David-Mengel/ECE-445-notebook---Tesla-Coil-Guitar-Amp-Group-13-2023/IMG_20231201_160136043_HDR.jpg

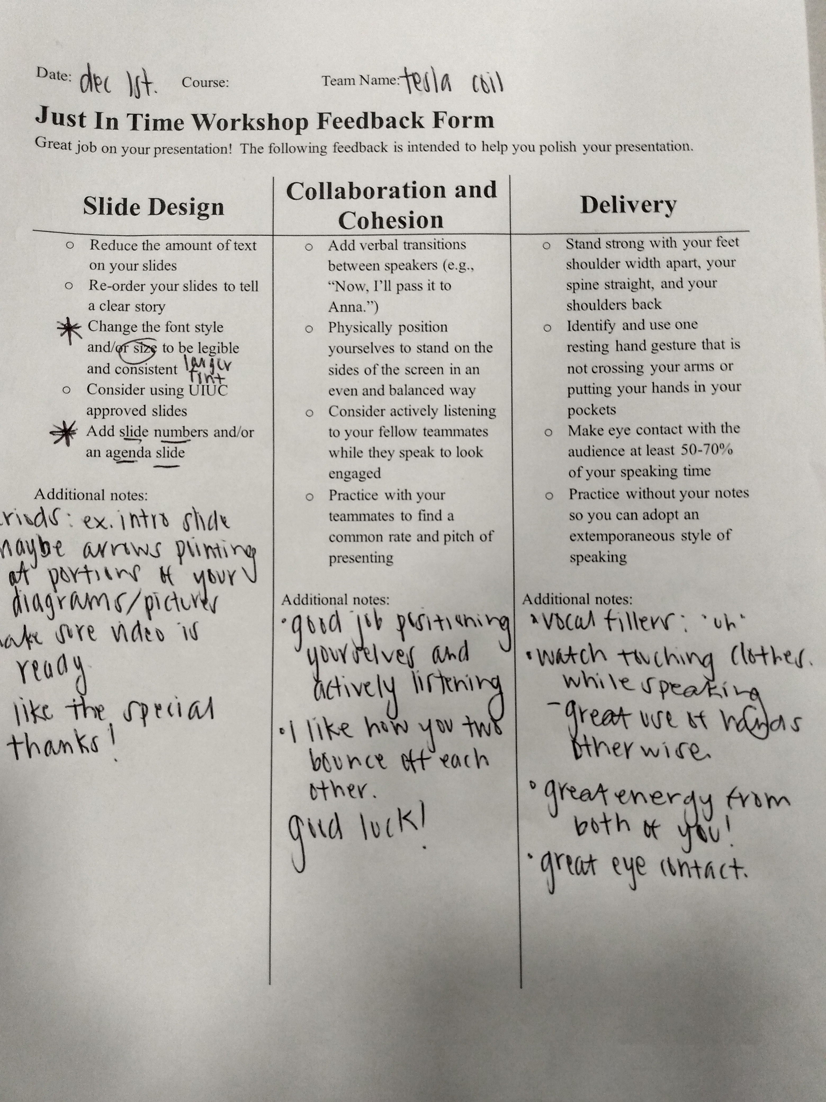
IMG_20231201_160136043_HDR.jpg
