David-Mengel/ECE-445-notebook---Tesla-Coil-Guitar-Amp-Group-13-2023/README

This repo contains the notes created by Griffin Rzonca and David Mengel for their ECE 445 project, the Tesla Coil Guitar Amp. 
For Final Report and other writeups, see Deliverables Folder
For information on when each file was written, see Version Information Document
Special thanks to Arne Fliflet, Jason Paximadas, and Arijit Banerjee for Guidance
