David-Mengel/ECE-445-notebook---Tesla-Coil-Guitar-Amp-Group-13-2023/MeetingNotes/10_2_23 Group Meeting.docx

Griffin Rzonca, David Mengel, Aditya Anand

ECE 445

10/2/23

Team 13 10/2 Meeting

Goals:

- Discuss gate drivers
- Discuss Audio processing goals
- Prepare for design review - 10/4 Wednesday, 12pm

Gate Drivers:

Do we need de-glitching?

Ask about gate driver circuit
