David-Mengel/ECE-445-notebook---Tesla-Coil-Guitar-Amp-Group-13-2023/MeetingNotes/11_7_23 TA Meeting.docx

11/7/23

Griffin Rzonca

ECE 445

11/7/23 Meeting with Jason

- Mock Demos next week
- Power board nearly soldered
- Audio Board arrived yet?
  - No
- 100k pot, actual ESP32 Wroom chip, USB/UART - need
- Still waiting on lab access to be approved
  - I’ll email them again
