David-Mengel/ECE-445-notebook---Tesla-Coil-Guitar-Amp-Group-13-2023/Audio Board/Coding the ESP32.docx

11/13/23

Griffin Rzonca

Coding the ESP32 Notes

- Testing with Devkit first
- Plug USB to microUSB connector into UART port
- Test with AD9850 board to ensure proper control
- AD9850 Arduino Library that may work with ESP32: AD985X/examples/AD9850_ESP32_HWSPI/AD9850_ESP32_HWSPI.ino at master · RobTillaart/AD985X · GitHub (https://github.com/RobTillaart/AD985X/blob/master/examples/AD9850_ESP32_HWSPI/AD9850_ESP32_HWSPI.ino)
