David-Mengel/ECE-445-notebook---Tesla-Coil-Guitar-Amp-Group-13-2023/Version Information.pdf

12/7/23

Griffin Rzonca and David Mengel

ECE 445, Team 13

Photo Screenshots of file dates

This file contains screenshots of the modification dates of each document in the lab notebook.

Dates are also included at the top of each file, but this document is intended to provide additional

context in a centralized location.

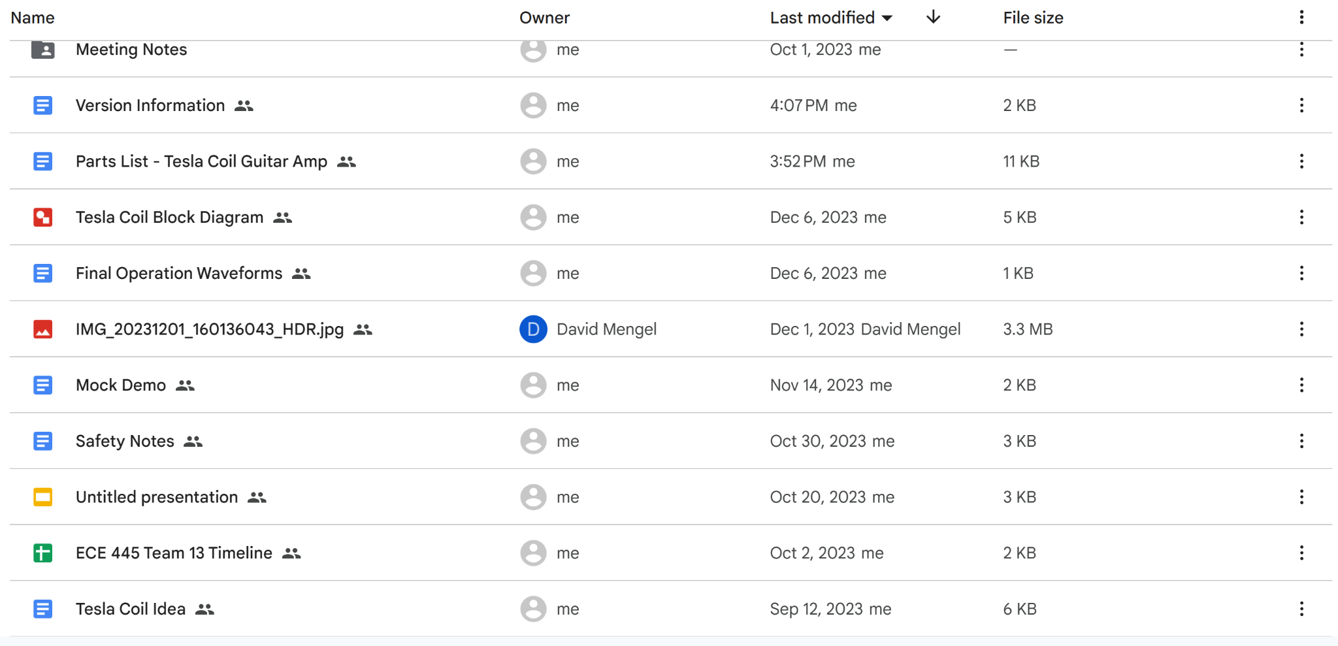
[picture p19: figure]

Above: Main folder version information

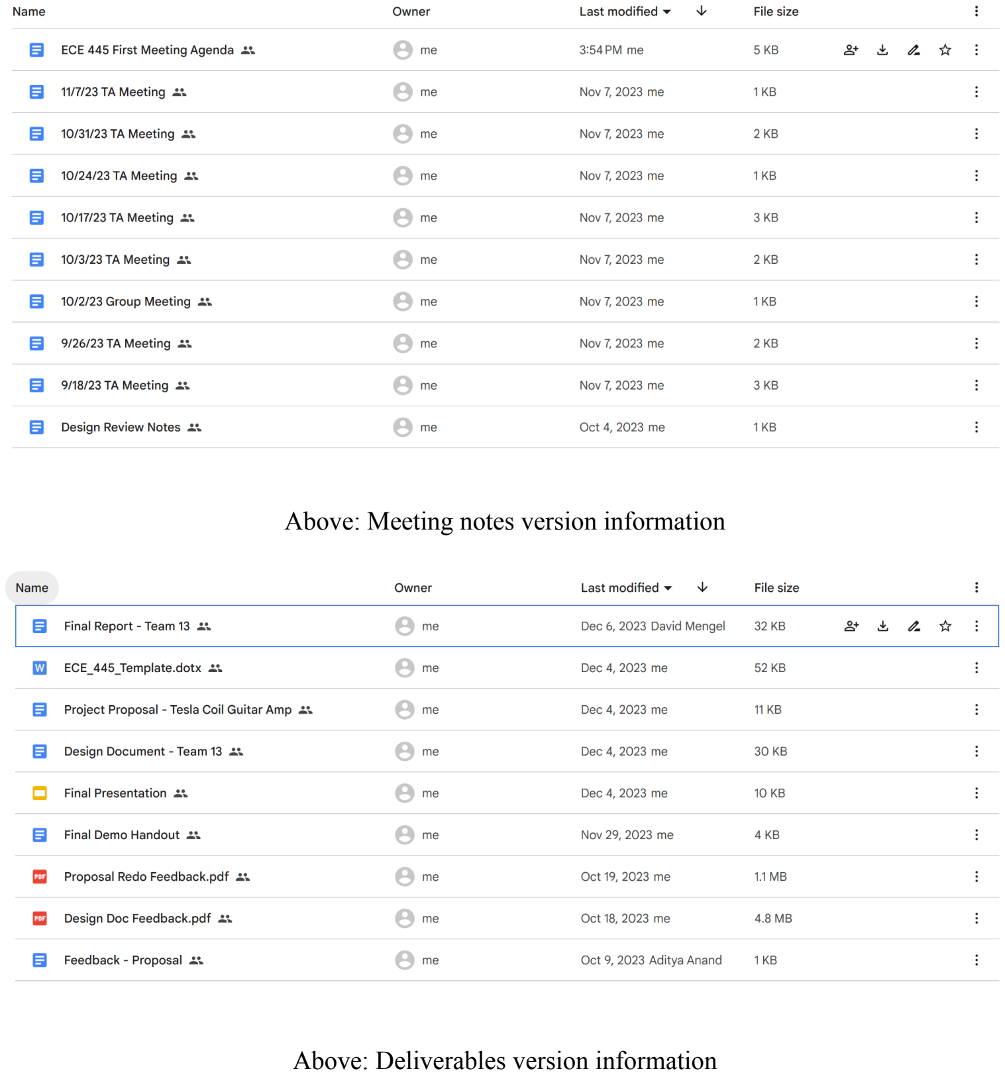
[picture p20: page 2]

Above: Meeting notes version information

Above: Deliverables version information

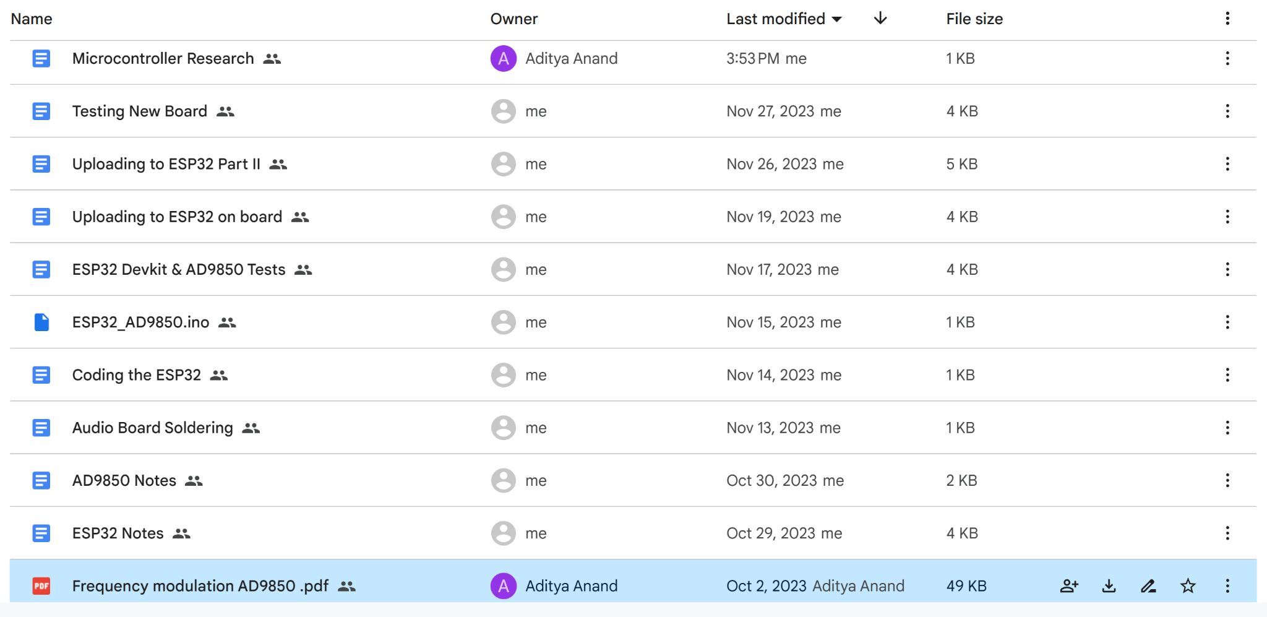
[picture p21: figure]

Above: Audio Board version information

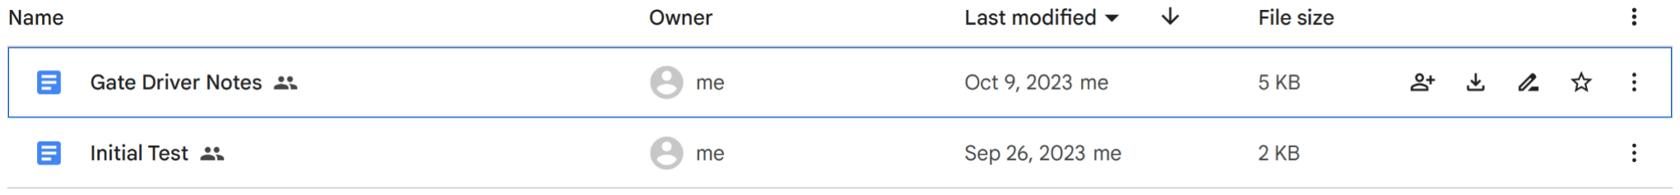
[picture p22: figure]

Above: Power Board version information
