David-Mengel/ECE-445-notebook---Tesla-Coil-Guitar-Amp-Group-13-2023/Tesla Coil Block Diagram.jpg

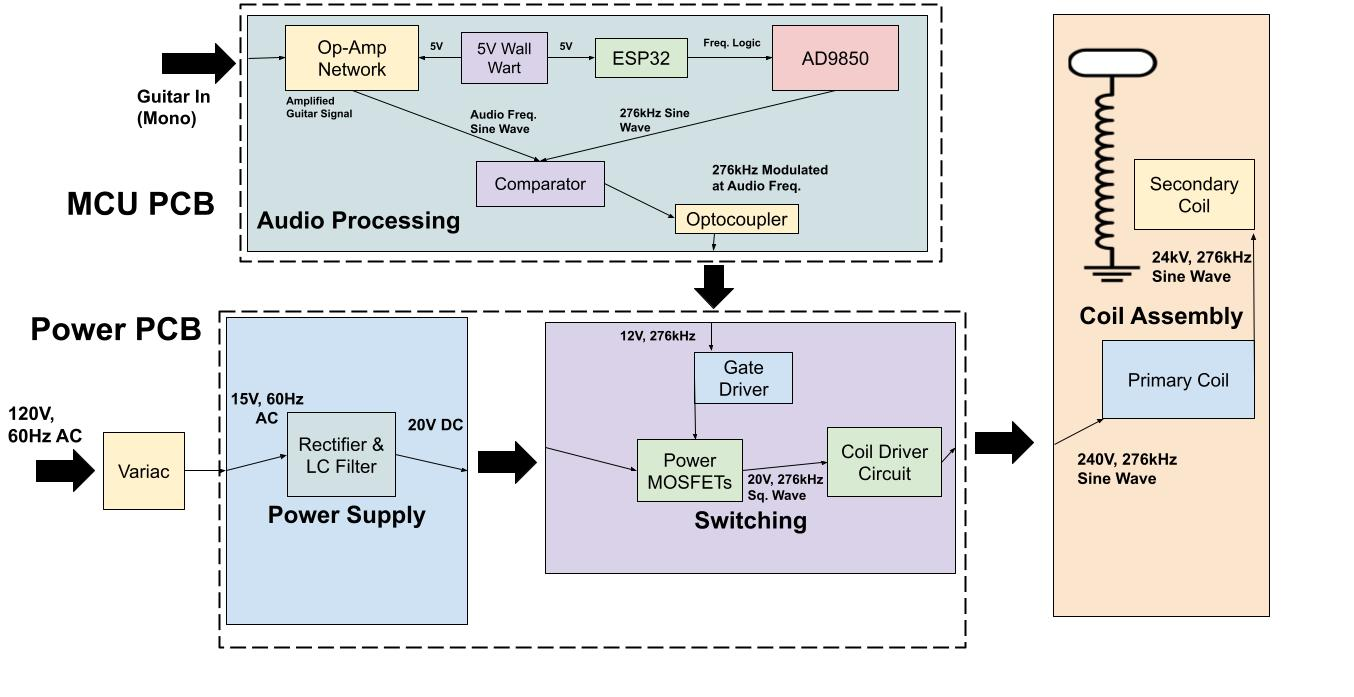
Tesla Coil Block Diagram.jpg
