David-Mengel/ECE-445-notebook---Tesla-Coil-Guitar-Amp-Group-13-2023/Parts List - Tesla Coil Guitar Amp.docx

Team 13 - Griffin Rzonca & David Mengel

ECE 445

Unsure about: Capacitors, AD9850, Wall Warts, and power strips, power/extension cord

Final list:

Gate driver:

2-mouser.com/ProductDetail/Skyworks-Solutions-Inc/SI82394CD4-IS?qs=7DnIVh14JBvCzUtYbocglg%3D%3D

Power Board:
Rectifier

2-https://www.mouser.com/ProductDetail/Diotec-Semiconductor/DB35-10?qs=OlC7AqGiEDlsV5lyy2qneA%3D%3D

Large Electrolytic capacitor:

In closet of 469 lab, or use https://www.mouser.com/ProductDetail/KEMET/ALC70A102EL500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

Smaller thin film capacitors: (10 Needed)
https://www.mouser.com/ProductDetail/Cornell-Dubilier-CDE/106MMR250K?qs=3tP%252BN51vMXeUCf%2FkKoeJiw%3D%3D

.05 uF capacitor

1-https://www.ebay.com/itm/171746725055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

Fuses:

10-https://www.mouser.com/ProductDetail/Bel-Fuse/5SF-10-R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 (could go different amperage)

Fuse Clips

10-https://www.mouser.com/ProductDetail/Littelfuse/52000001009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

Transistors

4-https://www.digikey.com/en/products/detail/stmicro/STW65N65DM2AG/5724364?

Circuit Breaker

2-https://www.mouser.com/ProductDetail/Qualtek/QLB-103-11B3N-3BA?qs=vbU4ZYfMnUr53F0RHGXmWA%3D%3D (Could go different amperage)

Diodes: In power lab

10-https://www.mouser.com/ProductDetail/Diotec-Semiconductor/1N4007?qs=OlC7AqGiEDmK9mU1uTiCkg%3D%3D

Other parts

Arduino Uno (provided)

Signal Generator https://www.walmart.com/ip/IC-AD9850-DDS-Signal-Generator-Module-0-40MHz-2-Sine-Wave-And-2-Square-Wave-Output-DIY-Test-Equipment-TE439/2817940150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

AD9850 DDS Signal Generator Module 0~40MHz 2 Sine Wave 2 Square Wave Output | eBay (https://www.ebay.com/itm/175879198580?campid=5338904988&toolid=20006&customid=255_255_255) ($13.50 but it’s Ebay)

5V Wall Wart (Need 2)

TOL-15312 SparkFun | Mouser (https://www.mouser.com/ProductDetail/SparkFun/TOL-15312?qs=PzGy0jfpSMtC9mElNzevIw%3D%3D) (5V, 2A)

12V Wall Wart (Need 1)

TOL-09442 SparkFun | Mouser (https://www.mouser.com/ProductDetail/SparkFun/TOL-09442?qs=WyAARYrbSnYUelhsIaixRA%3D%3D) (12V 600mA - Mouser)

DC Jack

5- https://www.sparkfun.com/products/10811

Coax Cable, 6 Feet (in power lab?)

Coax Jack (in power lab?)

Heat Sink (in power lab?)

Wall Plug (In power lab?)

Variac (in power lab?)

Parts to consider:

Power Supply:

- Rectifier
  - Looking into 3 phase rectifier
  - 35
  - Envistia Mall 1000V Metal 4-Pin Bridge Rectifier, White - KBPC5010 for sale online | eBay (https://www.ebay.com/p/25016784898?iid=192487028487) (1000V 50A, single phase, $6, oversized but looks good)
  - 4 Terminals Single-Phase Diode Bridge Rectifier MDQ 100A Amp High Power 1600V | eBay (https://www.ebay.com/itm/284811260927?hash=item425012f3ff:g:cIoAAOSwQ6FifJij) (1600V 100A, 8$, single phase, also oversized but looks good)
  - MDS150A 3 THREE Phase Diode Bridge Rectifier 1600V Diode Module | eBay (https://www.ebay.com/itm/354962330833?hash=item52a56754d1:g:-nYAAOSwHdVkmfM5) (1600V $12, 3 phase, may only do half wave though)
  - https://www.mouser.com/ProductDetail/Diotec-Semiconductor/DB35-10?qs=OlC7AqGiEDlsV5lyy2qneA%3D%3D 4 bucks, 3 phase, 35 A, 450 max surge rectifier.
- Variac
  - Possibly source from ECEB
- Fuse
  - BUSSMANN, 25 A, 600V AC, Fuse - 4XF13|JKS-25 - Grainger (https://www.grainger.com/product/BUSSMANN-Fuse-25-A-4XF13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) (25A, $60 tho 600V fuse)
  - Bussmann General Purpose Fuse One-Time 25 Amp 250 V K5 Ferrule Ld - Amazon.com (https://www.amazon.com/Bussmann-General-Purpose-One-Time-Ferrule/dp/B01MXLB9BJ?sp_csd=d2lkZ2V0TmFtZT1zcF9hdGY) (25A 250V, $8 but uses Amazon)
  - Cooper Bussmann 25 Amp Brass Cartridge Fuses (2-Pack) BP/NON-25 - The Home Depot (https://www.homedepot.com/p/Cooper-Bussmann-25-Amp-Brass-Cartridge-Fuses-2-Pack-BP-NON-25/100154449) (25A 250V, $5 Home Depot)

https://www.mouser.com/c/circuit-protection/fuses/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 1A

https://www.mouser.com/ProductDetail/Littelfuse/0618001.MXP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 1A

https://www.mouser.com/ProductDetail/Bel-Fuse/5SF-10-R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 10A

https://www.mouser.com/ProductDetail/Schurter/0034.3130?qs=sGAEpiMZZMsIz3CjQ1xegWrlMY7vL59hJdJw1f90RVI%3D 20A

https://www.mouser.com/ProductDetail/Schurter/8020.0607.G?qs=sGAEpiMZZMsIz3CjQ1xegdRKO5ZNZGpududAQvjt2Bo%3D 30A

https://www.mouser.com/ProductDetail/Phoenix-Contact/3061334?qs=sGAEpiMZZMsIz3CjQ1xegUhw130lehIK7aZLsZCXQBk%3D 10A, 1kV

https://www.mouser.com/ProductDetail/Schurter/0090.0020?qs=sGAEpiMZZMsIz3CjQ1xegaQ9EAopi3ZOiE9COU5F1cU%3D 20A, 1kV

https://www.mouser.com/ProductDetail/Schurter/0090.1030?qs=sGAEpiMZZMsIz3CjQ1xegaQ9EAopi3ZO%2FDg%2Fx5b8LcA%3D 30A, 1kV

All sorts of low-cost fuses, for input and output.

Fuse Clips
https://www.mouser.com/ProductDetail/Littelfuse/52000001009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 5mm

https://www.mouser.com/ProductDetail/Littelfuse/01240040H?qs=81r%252BiQLm7BQFxO8GsbEGhg%3D%3D 10mm

Audio Processing:

Gate Drivers:

MP1923GR-Z Monolithic Power Systems Inc. | Integrated Circuits (ICs) | DigiKey (https://www.digikey.com/en/products/detail/monolithic-power-systems-inc/MP1923GR-Z/18089800)

Can stand 100V, 8A, 7.2ns rise and 5.5ns fall

But, says 4.5V under-voltage lockout, may be a problem

$2.81

ZXGD3005E6TA Diodes Incorporated | Integrated Circuits (ICs) | DigiKey (https://www.digikey.com/en/products/detail/diodes-incorporated/ZXGD3005E6TA/2638862)

25V, 10A, can do up to and over 1MHz on load under 100nF, transistor we have Css is 5.5nF

$0.58

UCC27210DDAR Texas Instruments | Integrated Circuits (ICs) | DigiKey Marketplace (https://www.digikey.com/en/products/detail/texas-instruments/UCC27210DDAR/3137280)

7.2ns rise, 5.5ns fall, 20V 4A rating

$2.38

Switching:

# SIS176LDN-T1-GE3

SIS176LDN-T1-GE3 Vishay / Siliconix | Mouser (https://www.mouser.com/ProductDetail/Vishay-Siliconix/SIS176LDN-T1-GE3?qs=DRkmTr78QATBq6W8%252BCuvPg%3D%3D) (70V

BSC050N10NS5ATMA1 Infineon Technologies | Mouser (https://www.mouser.com/ProductDetail/Infineon-Technologies/BSC050N10NS5ATMA1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) (100V 100A, 9ns rise time 7ns fall time)

Coil Assembly:

Capacitor .05uF

https://www.ebay.com/itm/171746725055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

Capacitor 4.7uF

https://www.ebay.com/itm/144922056521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

Capacitor 3.3uF

https://www.ebay.com/itm/270870942012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

Things we may be able to borrow from power lab:

Heat Sinks

Wall Warts

Resistors
