David-Mengel/ECE-445-notebook---Tesla-Coil-Guitar-Amp-Group-13-2023/(commit log)

2023-12-07 General files
    [ECE 445 Team 13 Timeline.xlsx]
2023-12-07 Create Power Board folder
2023-12-07 Filled in Power Board
2023-12-07 Added Audio Board Files
